justinbeslity/Js5---Novel-Sap-Flux-Device/README.md

# Js5-Novel_Sap_Flux_Device
Repository for files related to the Js5 - a novel sap flux device
